jxay28/SvegliGiachiSebi/coversveglia.SLDASM

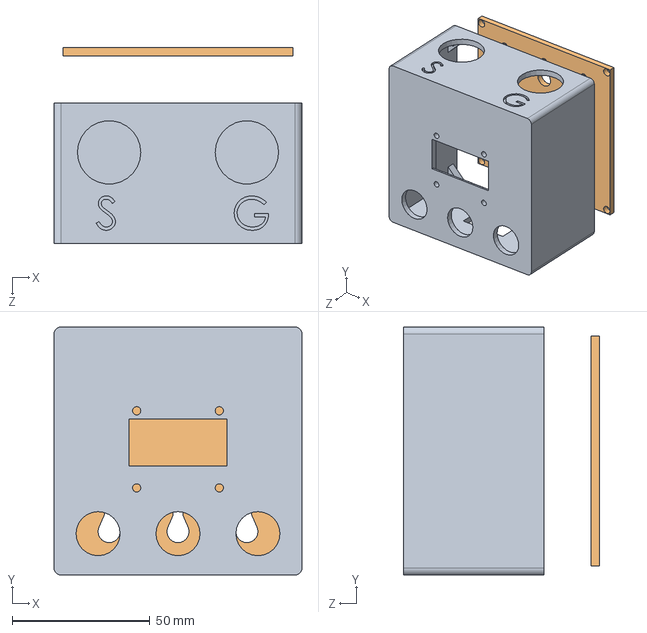
[picture p1: CAD file, 2026-11-01]
coversveglia.SLDASM
90.0 x 90.0 x 71.0 mm
COVER
coperchio
