jxay28/SvegliGiachiSebi/coperchio.SLDPRT

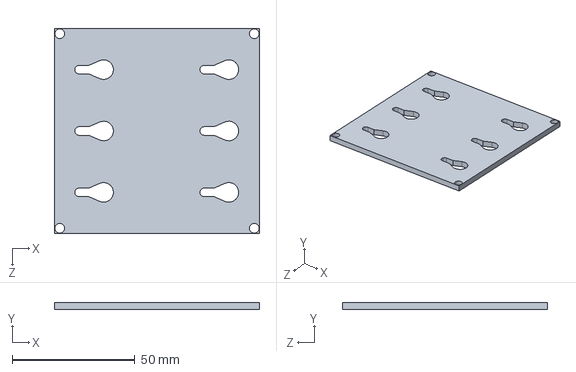
[picture p2: CAD file, 2026-11-01]
coperchio.SLDPRT
83.5 x 3.00 x 83.5 mm
