jxay28/SvegliGiachiSebi/COVER.SLDPRT

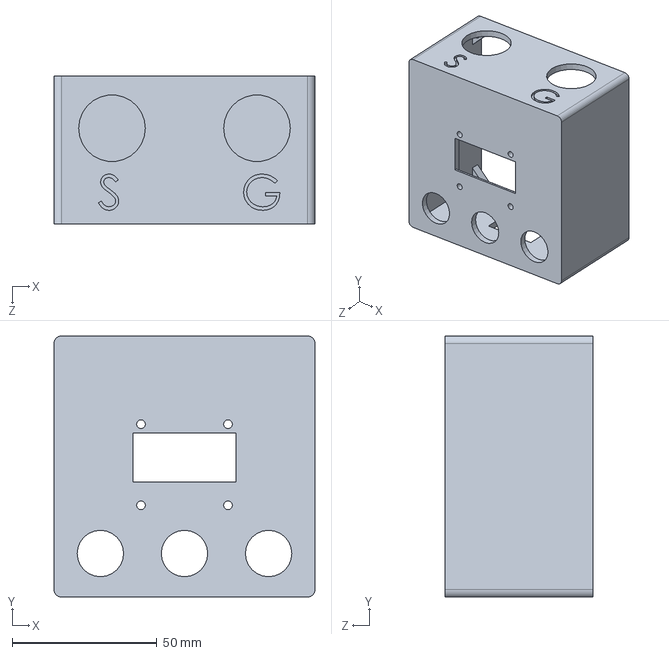
[picture p3: CAD file, 2026-11-01]
COVER.SLDPRT
90.0 x 90.0 x 51.0 mm
