jxay28/SvegliGiachiSebi/(list of files, cad)

Other CAD files:
COVER.STL
coperchio.STL
