jxay28/SvegliGiachiSebi/(commit log)

2026-11-01 Initialize Arduino alarm clock project
2026-11-01 Pubblica sveglia Nano completa con audio, CAD, backup e documentazione dettagliata
    [COVER.SLDPRT, COVER.STL, coperchio.SLDPRT, coperchio.STL, coversveglia.SLDASM]
